Darnelo-Inc/8bit/CPU.jpg

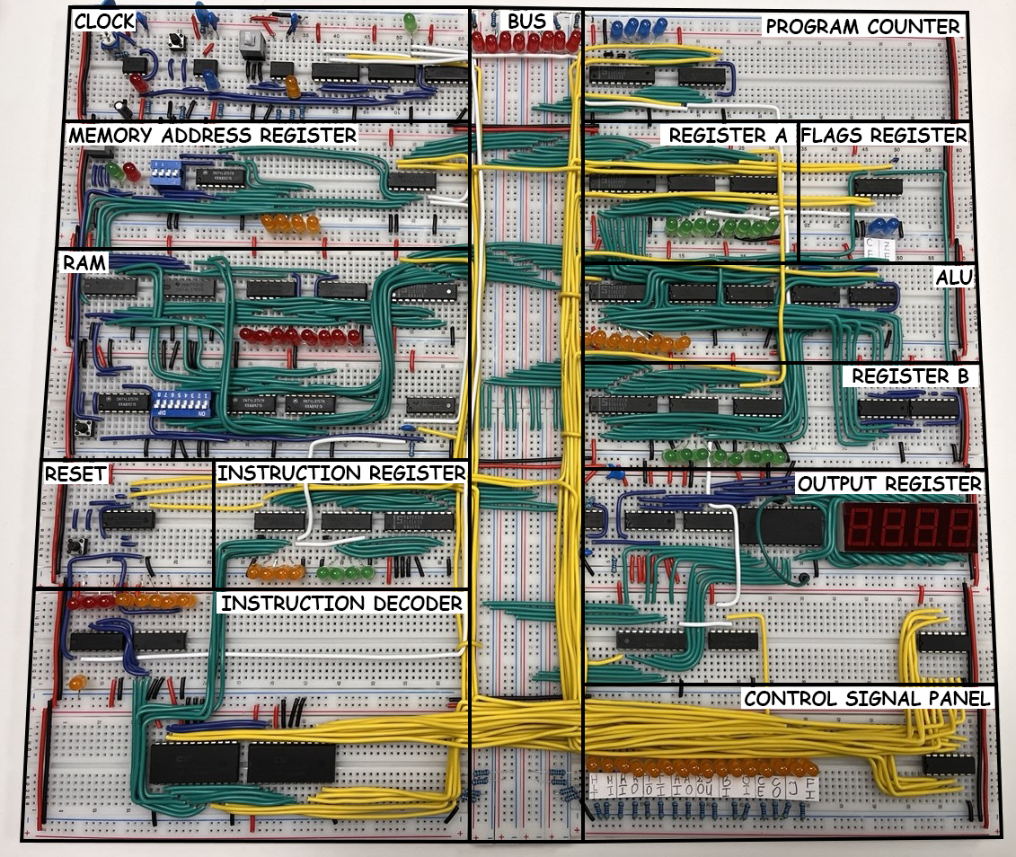
CPU.jpg
