Darnelo-Inc/8bit/README.md

# ОГЛАВЛЕНИЕ ВКР  
**Тема**: «Разработка интерактивного учебного пособия для изучения устройства и работы компьютера»

## Введение  
1. **Актуальность исследования**  
   - Необходимость упрощения сложных технических концепций для базового понимания архитектуры компьютера.  
   - Преимущества физических моделей перед виртуальными симуляторами в образовательном процессе (тактильное взаимодействие, наглядность).  
   - Роль интерактивности в повышении вовлечённости студентов при изучении низкоуровневых процессов.  

2. **Цель работы**  
   Разработать и технически обосновать интерактивную аппаратную модель компьютера, демонстрирующую базовые принципы его работы через визуализацию процессов и ручное управление компонентами.  

3. **Задачи исследования**  
   - Провести анализ существующих образовательных моделей и выявить их ограничения.  
   - Сформулировать требования к аппаратной реализации учебного пособия.  
   - Реализовать модель с возможностью ручного управления тактами и визуализацией данных.  
   - Провести тестирование функциональности модели и оценить её образовательную ценность.  

---

## Глава 1. Анализ существующих решений и обоснование разработки  
### 1.1. Сравнение образовательных моделей  
- **Университетские стенды**:  
  - Физические модели МГТУ им. Баумана (сложность настройки, закрытая архитектура).  
  - Лабораторные стенды СПбГЭТУ (высокая стоимость, ориентация на продвинутых студентов).  
- **Коммерческие аналоги**:  
  - Ben Eater’s 8-bit breadboard computer (открытая архитектура, но требующая самостоятельной сборки).  
  - Учебные наборы на базе Arduino (ограниченная визуализация процессов).  

### 1.2. Критерии сравнения  
- Возможность ручного управления тактами.  
- Наличие визуализации данных в реальном времени.  
- Доступность модификации программ через физический интерфейс.  
- Стоимость и ремонтопригодность.  

### 1.3. Обоснование разработки  
- Отсутствие доступных моделей с сочетанием:  
  - Физического интерфейса для ввода программ.  
  - Визуализации всех этапов выполнения команд.  
  - Режима ручного тактирования.  

---

## Глава 2. Разработка и тестирование аппаратной модели  
### 2.1. Требования к модели  
- **Функциональные**:  
  - Ручной ввод данных через переключатели.  
  - Визуализация состояния регистров и памяти через светодиоды.  
  - Управление тактами (ручное/автоматическое).  
- **Технические**:  
  - Использование EEPROM для хранения микрокода.  
  - Вывод результатов на 7-сегментный дисплей в десятичном формате.  

### 2.2. Архитектура модели  
- **Основные компоненты**:  
  - Блок управления (EEPROM с прошивкой через Arduino).  
  - АЛУ на базе логических микросхем.  
  - Регистры общего назначения (4- и 8-битные).  
  - Память (RAM) с ручным вводом данных.  
  - Тактовый генератор с регулируемой частотой.  
- **Логика работы**:  
  - Преобразование инструкций в управляющие сигналы через EEPROM.  
  - Последовательность: выборка команды → декодирование → выполнение.  

### 2.3. Ключевые архитектурные решения  
- **Упрощение vs современные компьютеры**:  
  - Отказ от многоуровневой памяти (кеши, виртуальная память) → только RAM.  
  - Замена конвейерной обработки на последовательное выполнение команд.  
  - Использование 8-битной шины вместо 64-битной.  
- **Обоснование упрощений**:  
  - Позволяет визуализировать базовые принципы без "зашумления" сложными оптимизациями.  
  - Соответствует задачам начального уровня обучения.  

### 2.4. Реализация интерфейса  
- **Управление**:  
  - Переключатели для задания адреса и данных.  
  - Кнопки: «Такт», «Сброс», «Режим тактирования».  
- **Визуализация**:  
  - Светодиодные индикаторы для регистров (4/8 бит).  
  - 7-сегментный дисплей для вывода результатов в 10-СС.  

### 2.5. Методика тестирования  
- **Модульные тесты**:  
  - Проверка работы АЛУ (сложение, вычитание).  
  - Тестирование регистров на запись/чтение.  
  - Валидация памяти (корректность адресации).  
- **Интеграционные тесты**:  
  - Выполнение программы «Сумма чисел от 1 до N».  
  - Генерация последовательности Фибоначчи.  
- **Ручное тестирование**:  
  - Имитация ошибок (неверный адрес, конфликт данных).  
  - Проверка реакции на сброс.  

### 2.6. Результаты тестирования  
- Успешное выполнение 25 тест-кейсов (20 модульных, 5 интеграционных).  
- Обнаружение и устранение ошибок синхронизации тактов.  
- Демонстрация работы модели на примере учебных программ.  

---

## Заключение  
1. Разработана аппаратная модель, позволяющая изучать принципы работы компьютера через тактильное взаимодействие.  
2. Модель прошла валидацию и готова к использованию в учебном процессе.  
3. Основное преимущество — прозрачность процессов за счёт визуализации и ручного управления.  

---

## Приложения  
**A.** Фото модели с описанием компонентов.  
**B.** Инструкция по взаимодействию с моделью компьютера.  
**C.** Примеры тестовых программ с пошаговым выполнением.  
**D.** Результаты ручного тестирования.
