Darnelo-Inc/8bit/(commit log)

2025-04-05 Введение, цель, задачи
2025-04-12 Первая глава
2025-04-13 Требования к модели. Архитектура модели
2025-04-16 Основна часть и заключение завершены.
2025-04-19 Приложение
